upoulin/Securino-Vault/README.md

# Securino Vault

Coffre sécurisé créé avec Arduino pour un projet scolaire.
En collaboration avec : [**@DavRide**](https://github.com/davride)

## Description

Il s'agit d'un coffre-fort à double sécurité. Il vérifie d'abord si une carte de sécurité (puce RFID) est valide, puis génère un code numérique à l'aide d'un moteur. Il sera possible de changer le code et de verrouiller le coffre après 5 tentatives.
