upoulin/Securino-Vault/Documentation/ListeMatériel.md

# Liste du matériel / composants :

- 1 Arduino UNO
- 1 Lecteur RFID RC522 + Carte + Badge
- 1 Clavier à code
- 2 Servo Moteurs SG90
- 1 Buzzer
- 1 Batterie (caractéristiques à déterminer)
- 3 LEDS : Rouge, Orange, Verte
- 2 + 3 Résistances (Pont diviseur + LEDS)
- 1 Breadboard
