upoulin/Securino-Vault/Documentation/Cahier Des Charges.md

***********************
# Cahier des charges :
***********************
(Résiste à IEM)
(Alarme quand mauvais code ou mauvais RFID)
Sécuriser des objets mis à l'intérieur du coffre
Controler l'ouverture du coffre par badge RFID puis par un Digicode :
- Vérification de l'information RFID
- Vérification de la saisie du Digicode

Liste des matériels / composants :

1 Arduino UNO
1 Lecteur + Carte RFID
1 Clavier Digicode
2 Servo Moteurs
1 Buzzer
1 Batterie (caractéristiques à déterminer)
