upoulin/Securino-Vault/Documentation/Planning.md

## Schedule
| | To do
|---|---|
|Week 1|CDC, liste des matériels avec fonctions et leur fonctionnement détaillé|
|Week 2|Dimensions et dessin de toutes les pièces + début code|
|Week 3|Modélisation de toutes les pièces + code|
|Week 4|Maquette du coffre et rectifications|
|Week 5|Impression de toutes les pièces et Implémentations led|
|Week 6|Implémentation blocage et assemblage|
|Week 7|Derniers détails|
|Week 8|Présentation|
