upoulin/Securino-Vault/Rapport seances/POULIN/UlyssesPOULIN_8.md

*******************
# Rapport 
*******************

## Séance du 23 Février

### Code

Au cours de cette séance, j'ai effectué une dernière révision de mon code en apportant quelques modifications :

- Correction d'un problème lié aux IO des LEDs.
- Verrouillage du cache même si le code n'est pas correct (en appuyant sur B, le cache descend même si le digicode n'est pas validé).
- Réduction du délai de verrouillage du coffre de 5 minutes à 30 secondes pour faciliter la démonstration.

### Tests finaux

J'ai entrepris des tests finaux en explorant toutes les configurations possibles du code pour m'assurer qu'aucune correction supplémentaire n'était nécessaire.

### Montage final

J'ai contribué au montage final en découpant les côtés de la porte afin que les charnières puissent être installées sans être visibles.
