upoulin/Securino-Vault/Rapport seances/POULIN/UlyssesPOULIN_4.md

*******************
# Rapport 
*******************

## Séance du 15 Décembre

### Code

Suite à la présentation orale, une alternative de codage des états a été discutée, visant à améliorer la compréhension du code et à adopter une approche plus conventionnelle. La proposition consiste à utiliser plusieurs états distincts, notamment :

- **Entrée valide :**
  Un code d'état indiquant que la séquence de chiffres entrée par l'utilisateur est correcte.

- **Entrée invalide :**
  Un état signalant que la séquence de chiffres entrée n'est pas valide, pouvant être trop courte, trop longue, ou ne correspondant pas à un code autorisé.

- **Attente d'entrée :**
  Un état indiquant que le digicode est prêt à recevoir une nouvelle entrée.

- **Limite d'essais dépassée :**
  Un code d'état signalant que l'utilisateur a dépassé le nombre maximal d'essais autorisés.

- **Succès :**
  Un état pour signaler que l'entrée a été validée avec succès.

- **Échec :**
  Un état pour indiquer que l'entrée a échoué.
  
- **Nombre entré :**
Un état pour indiquer qu'un nombre a été entré sur le digicode.

J'ai commencé a coder ces états et je continuerai la semaine prochaine. Egalement je demanderais aux professeurs si la manière de faire est la bonne.

### Capteur RFID

Une tentative a été faite pour évaluer la distance à laquelle la carte RFID pourrait être lue par le capteur à travers le bois. Malheureusement, cette expérience a échoué en raison de contraintes de temps. Des essais supplémentaires pourraient être nécessaires pour déterminer la meilleure configuration.

### Fixation des composants

Suite à une réflexion approfondie, il a été décidé d'utiliser du scotch double face ou du gaffer retourné pour fixer les composants sur le bois. Cette approche permettra l'utilisation d'une plaque plus fine, probablement d'une épaisseur de 3 mm pour la face avant et arrière, et de 5 mm pour les côtés. Cette solution renforcera la sécurité du coffre en évitant de fragiliser le bois, tout en facilitant le démontage. Cependant, il est important de noter que le scotch pourrait ne pas assurer une fixation permanente et devra éventuellement être remplacé.
