upoulin/Securino-Vault/Rapport seances/POULIN/UlyssesPOULIN_1.md

*******************
# Report 
*******************
## Création github du Github le 8 Décembre
 - ##### Création du projet sous Github pour la remise des comptes rendus ainsi que le dépot de nos codes.
 - ##### Création du ReadME
## Seance du 11 Décembre
 - ##### Demande du matériel
 - ##### Mise en place du projet
 - ##### Commencement de la mise en place de la liste du materiel
 - ##### Test des composants (digicode et moteur David s'est occupé du RFID)
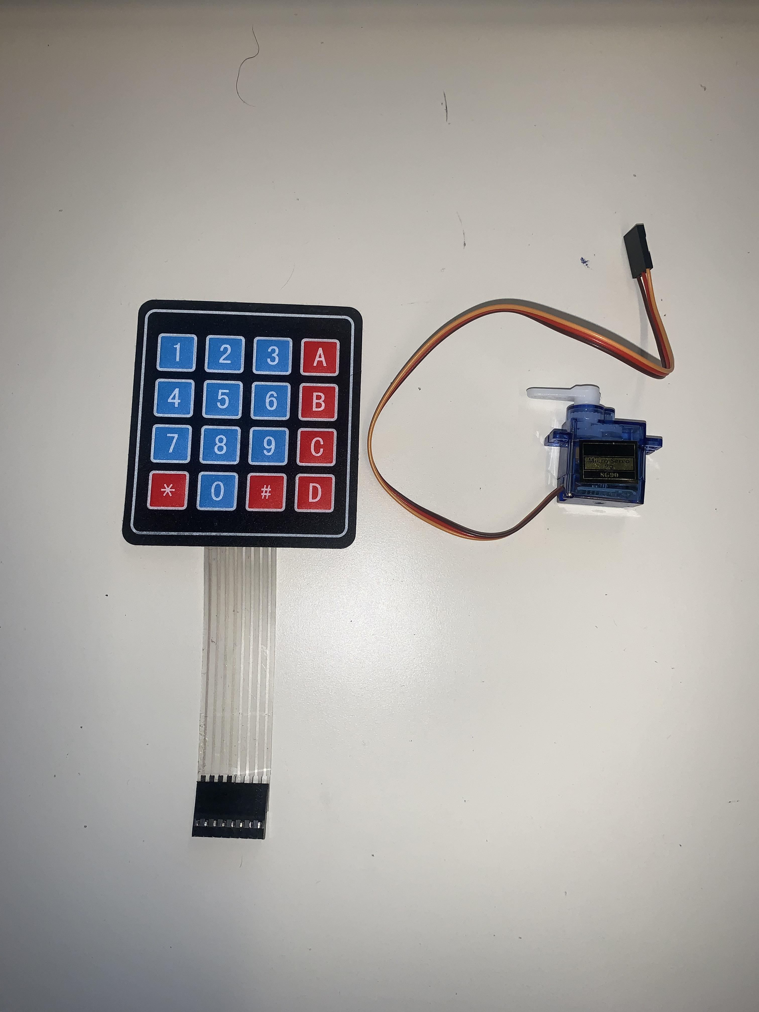
[picture p31: Images/digicode_moteur.jpg]
composants
