upoulin/Securino-Vault/Rapport seances/BERMON/Séance n°1 Bermon.md

# Rapports de Séances : David Bermon
## Séance 1 :  11 Décembre 2023
 - Mise en place du projet.
 
 - Etablissement du [Cahier des Charges et Fonctions](../Documentation/CahierDesCharges.md) (non définitif).
 - Etablissement de la [Liste du Materiel](../Documentation/ListeMatériel.md) (non définitive).
 - Demande du matériel.
 - Test des composants : Lecteur RFID et Buzzer.
 composants
