upoulin/Securino-Vault/Documentation/CahierDesCharges.md

# Cahier des charges :
- Sécuriser des objets mis à l'intérieur du coffre.
  
- Controler l'accès et l'ouverture coffre par badge RFID puis par un clavier à code.
- Avertissement d'intrusion dans le coffre.
- Empécher que les objets stockés ne restent bloqués dans le coffre en cas de coupure électrique. 

# Fonctions : 
- Vérification de l'information RFID.
- Vérification de la saisie du code.
- Indication lumineuse et sonore lors des controles :
  
    + Signal "positif" si l'information est correcte.
    + Signal "négatif" si l'information est incorrecte.
- Initialisation et changement du code (procédure à enclencher sur le clavier quand le coffre est ouvert).
- Verrouilage du coffre par appui sur le clavier.
- Déclenchement d'une alarme au bout de 5 échecs lors du contrôle.
- Indication d'un niveau faible de batterie (fermeture impossible).
