upoulin/Securino-Vault/Images/rfid_buzzer.jpg

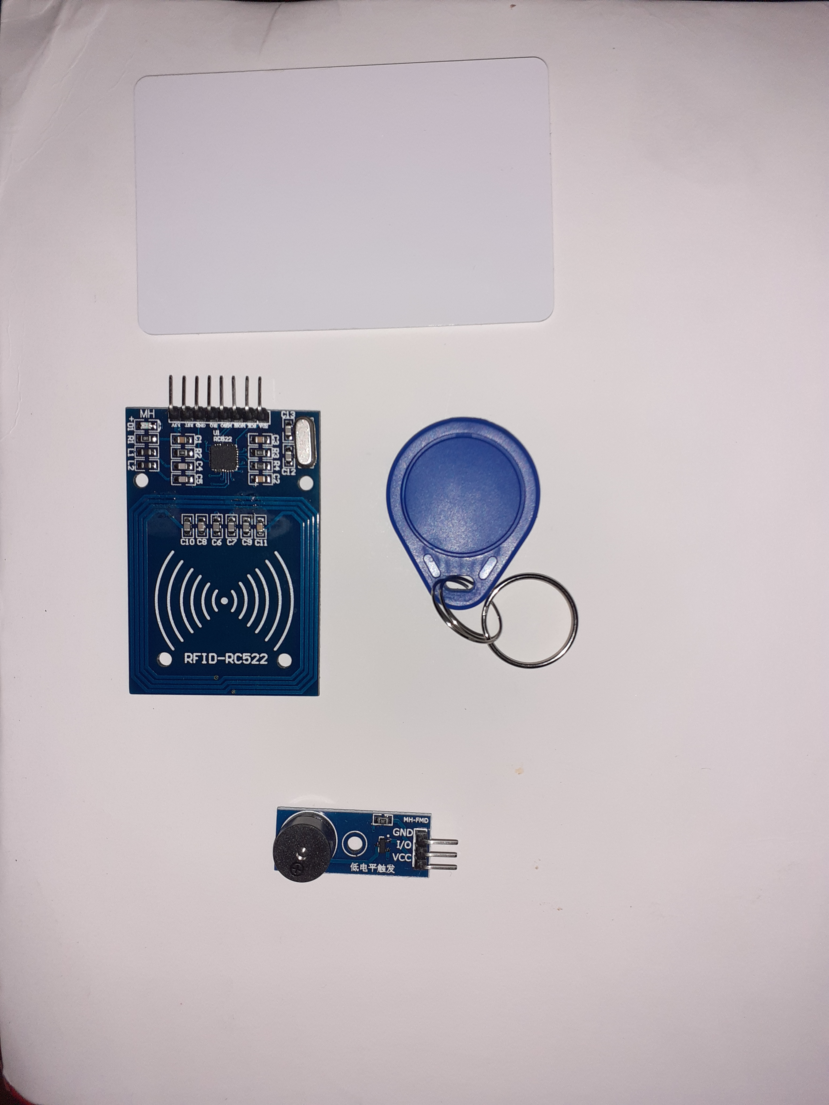
Images/rfid_buzzer.jpg
