upoulin/Securino-Vault/(commit log)

2023-12-12 Cahier Des Charges
2023-12-12 Rename Cahier Des Charges to Cahier Des Charges.md
2023-12-12 Update and rename Cahier Des Charges.md to CahierDesCharges.md
2023-12-19 Rename Rapport seances/DavidBERMON.md to Rapport seances/BERMON/Séance n°1 Bermon.md
    Pas de modifications du rapport, juste un déplacement dans un dossier
